leg1231/weird-looking-f1-car/README.md

# weird-looking-f1-car
I built a RC f1 car that uses motors that are to large.

The motors are from a hoverboard that I got that was broken, so as one does they put it in a little car that creates enough torque to do a burnout at 25% throttle. You can use it however you like, I drive it around a parking lot, if you want to build two you could race them. 

Features
- each wheel is individually stearable( revers or positve ackerman)
- 3d printed ( easy to repair)
- FUN
- 3ft long
- personalizable
- driftable

- I don’t have a full step file of all parts because it was to large :)

38F4417C-0CD1-4FBF-A528-06B974A8FFAD_1_105_c

DDD26E48-8DF4-418B-BD40-80D3314D60D0_1_105_c

770DDBE2-6F72-454E-91C3-B64E4C116AA4_1_105_c
