leg1231/weird-looking-f1-car/code/Instrustions -code (1).pdf

## Code Instructions

- Install micro python onto 2 raspberry pi pico 2’s
- Once installed, download the lora library file
- Save the lora library code onto both picos as “lora.py”
- Download the receiver code and the transmitter code
- Save the receiver code onto a picos as “main.py”
- Mark which one you have as the receiver
- Save the transmitter code onto the other as “main.py”
- Mark the transmitter code as transmitter
