leg1231/weird-looking-f1-car/wire diagram/receiver_ car.png

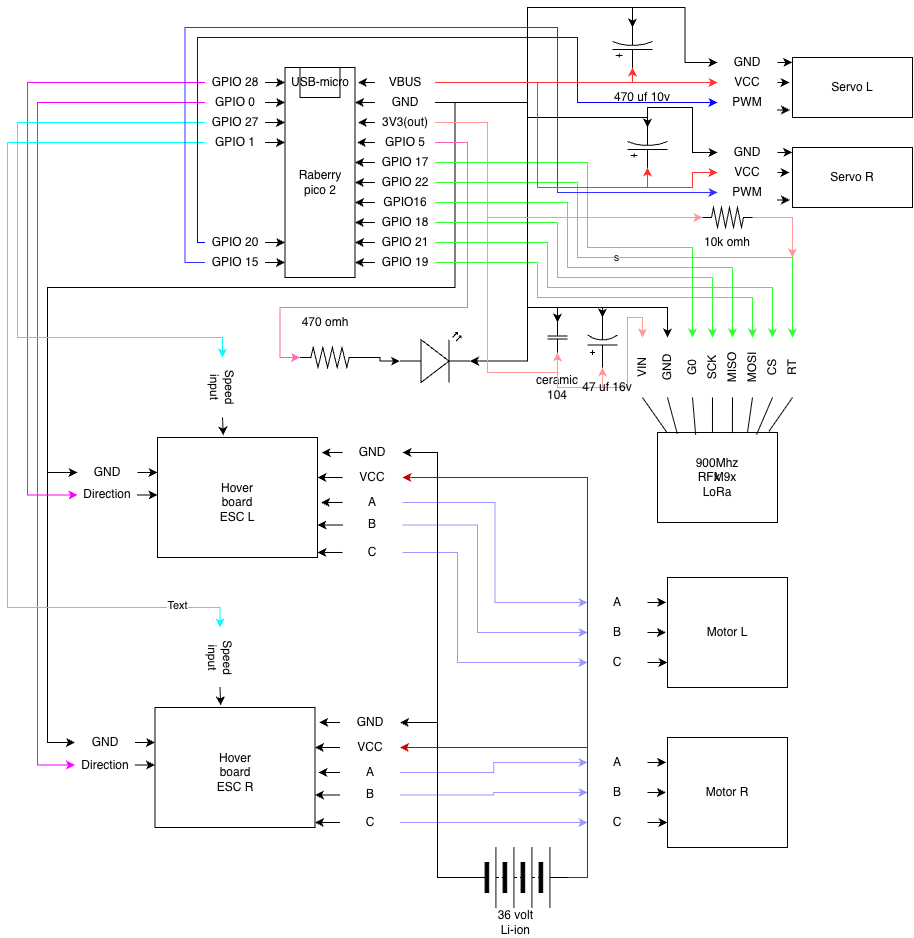
wire diagram/receiver_ car.png
