leg1231/weird-looking-f1-car/wire diagram/transmitter_ remote.png

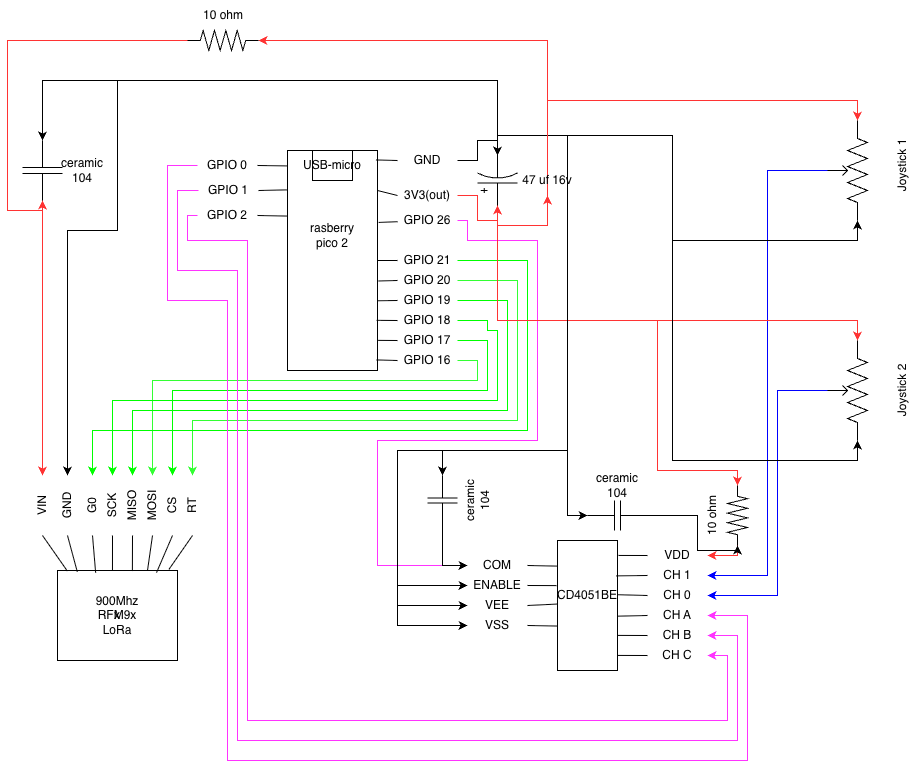
wire diagram/transmitter_ remote.png
