leg1231/weird-looking-f1-car/BOM - Sheet1.csv

ITEM | PRICE | LINK
#10-32TPI 5/8in screw x26 | $6.28 | https://www.homedepot.com/p/Everbilt-10-32-x-5-8-in-Zinc-Plated-Combo-Round-Head-Machine-Screw-8-Pack-828551/317479056
#10-32TPI 1 1/4in screw x8 | $3.14 | https://www.homedepot.com/p/10-32-x-1-1-4-in-Zinc-Plated-Combo-Round-Head-Machine-Screw-5-Pack-830641/317479059
#10-32TPI nuts x34 | $4.71 | https://www.homedepot.com/p/Everbilt-10-32-Zinc-Plated-Machine-Screw-Nut-12-Pieces-826331/317478809
#10 washers x68 | $6.87 | https://www.homedepot.com/p/Everbilt-10-Zinc-Flat-Washer-100-Pack-800442/204276404
8x22x7mm bearings x14 | $19.25 | https://www.amazon.com/gp/product/B0BZT4WDCG/ref=ox_sc_act_title_7?th=1
steering servos x2 | $37.98 | https://www.amazon.com/gp/product/B0CCDN233L/ref=ewc_pr_img_13?smid=A2QTZX14X1D97I&psc=1
motor battery | $41.99 | https://www.amazon.com/gp/product/B0HKS4WVCJ/ref=ewc_pr_img_1?smid=A3L98XJAOS9GRC&psc=1
pico battery | $7.59 | https://www.amazon.com/cart/smart-wagon?newItems=5b2092ab-e2e2-4336-8974-d1ee8a0231cd,1
perfboard | $9.99 | https://www.amazon.com/cart/smart-wagon?newItems=e81c6068-6d89-4af6-82b2-67d0c99dd422,1
electrolytic capacitor | $9.99 | https://www.amazon.com/gp/product/B0F1V24SG9/ref=ewc_pr_img_17?smid=ARPNI681JK4HR&psc=1
ceramic capacitors | $6.99 | https://www.amazon.com/gp/product/B07X5XTDPB/ref=ewc_pr_img_18?smid=A2RFXKS6GNXFWP&psc=1
LoRa modual x2 | $39.90 | https://www.adafruit.com/product/3072
Pico 2 x2 | $12.50 | https://www.adafruit.com/product/6006
CD4051 | $6.99 | https://www.amazon.com/cart/smart-wagon?newItems=8668cab5-509c-4a83-8b9f-52ce7bab90b8,1
Joystick | $13.99 | https://www.amazon.com/gp/product/B09JZ8ZV4L/ref=ewc_pr_img_20?smid=ADJSE8KRWYR5&psc=1
motors esc x2 | $29.18 | https://www.amazon.com/gp/product/B0DBSNV86J/ref=ewc_pr_img_5?smid=A1ASY00QOMN6RD&psc=1
hoverboard motors | $10.00 | find a broken hoverboard and use the motors- i found one at goodwill
PLA 5kg | $67.45 | https://us.store.bambulab.com/products/pla-basic-filament
TPU 85A 1kg | $44.99 | https://us.store.bambulab.com/products/tpu-85a-tpu-90a?id=573761693833371666
