leg1231/weird-looking-f1-car/CAD files/base plate/Motor holder RIGHT.step

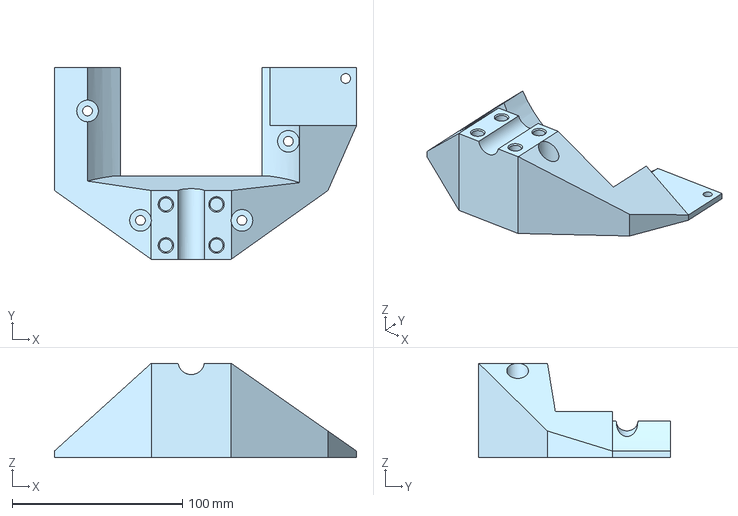
[picture p3: CAD file, 2026-10-25]
CAD files/base plate/Motor holder RIGHT.step
177.2 x 112.4 x 55.3 mm
