leg1231/weird-looking-f1-car/CAD files/body/chassi dowls - Part 1.step

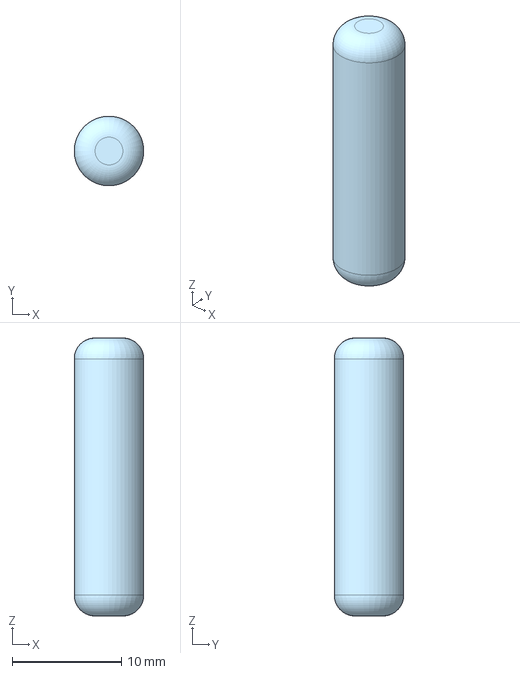
[picture p4: CAD file, 2026-10-25]
CAD files/body/chassi dowls - Part 1.step
6.34 x 6.35 x 25.4 mm
