leg1231/weird-looking-f1-car/CAD files/drive train/gear mount LEFT.step

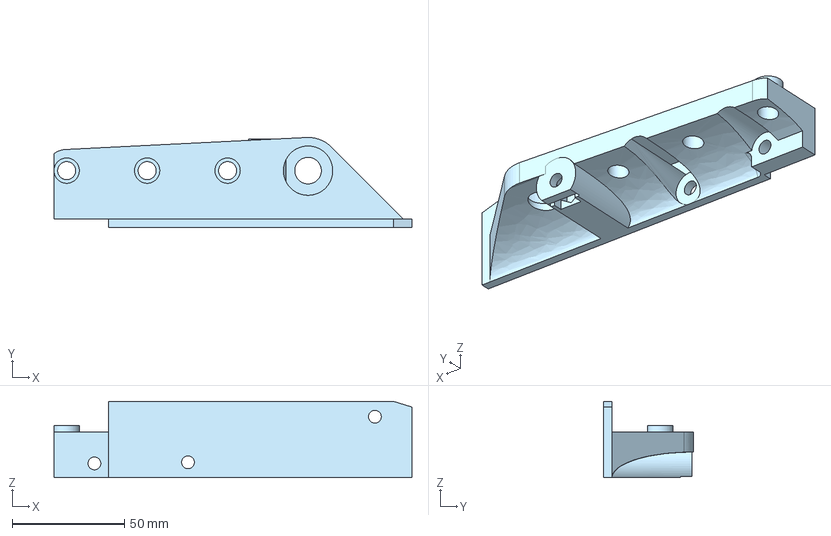
[picture p5: CAD file, 2026-10-25]
CAD files/drive train/gear mount LEFT.step
159.7 x 40.2 x 34.0 mm
