leg1231/weird-looking-f1-car/CAD files/steering LEFT/front wing cap (2).step

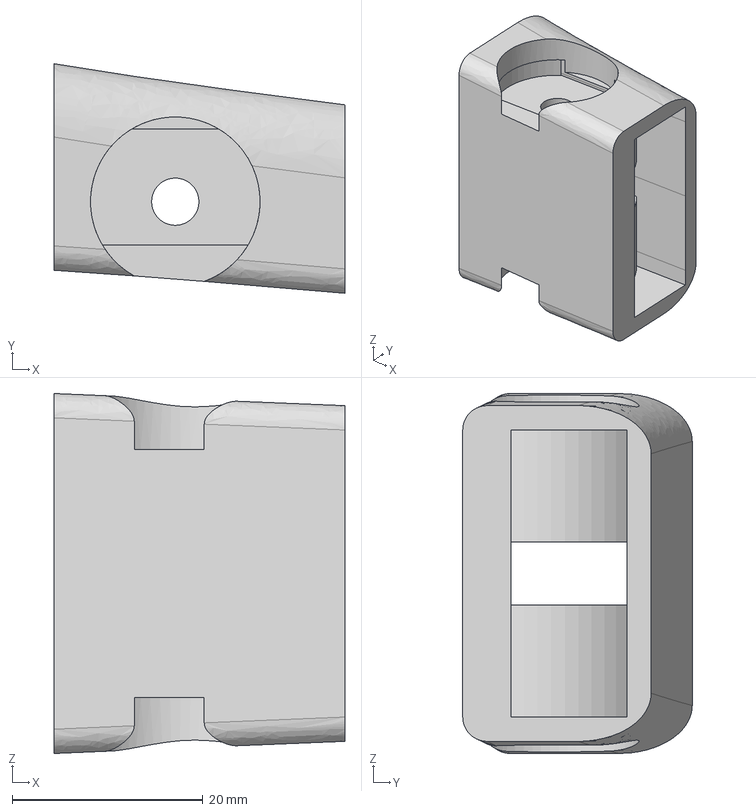
[picture p6: CAD file, 2026-10-25]
CAD files/steering LEFT/front wing cap (2).step
30.5 x 24.1 x 37.8 mm
