leg1231/weird-looking-f1-car/CAD files/steering nuckle RIGHT.step

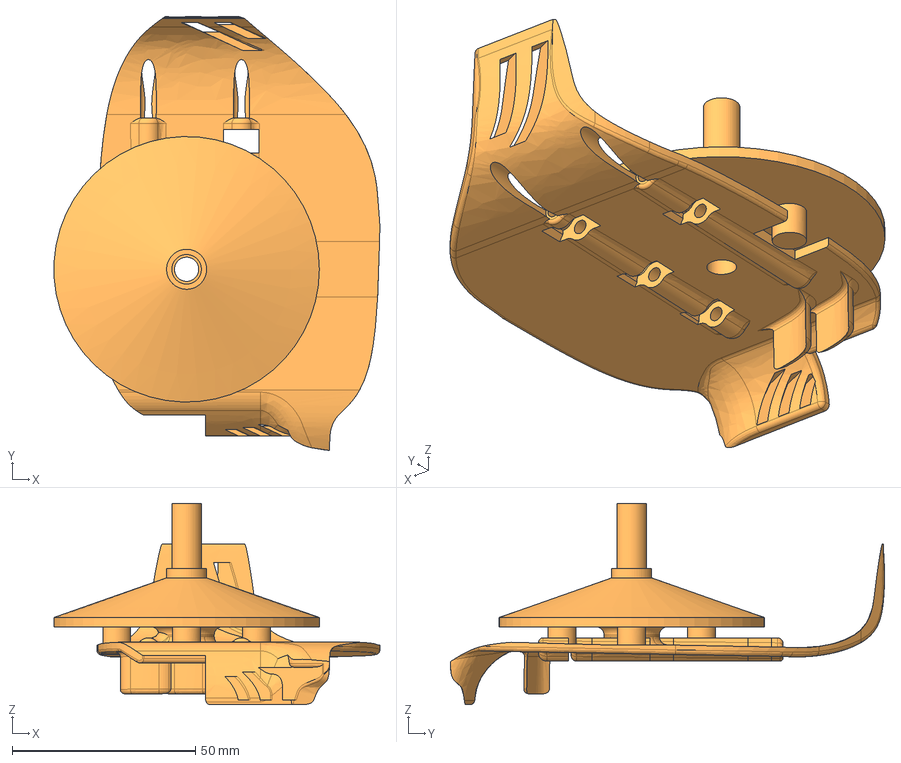
[picture p7: CAD file, 2026-10-25]
CAD files/steering nuckle RIGHT.step
88.8 x 118.3 x 54.9 mm
