leg1231/weird-looking-f1-car/CAD files/steering RIGHT/Wheel rim FRONT.step

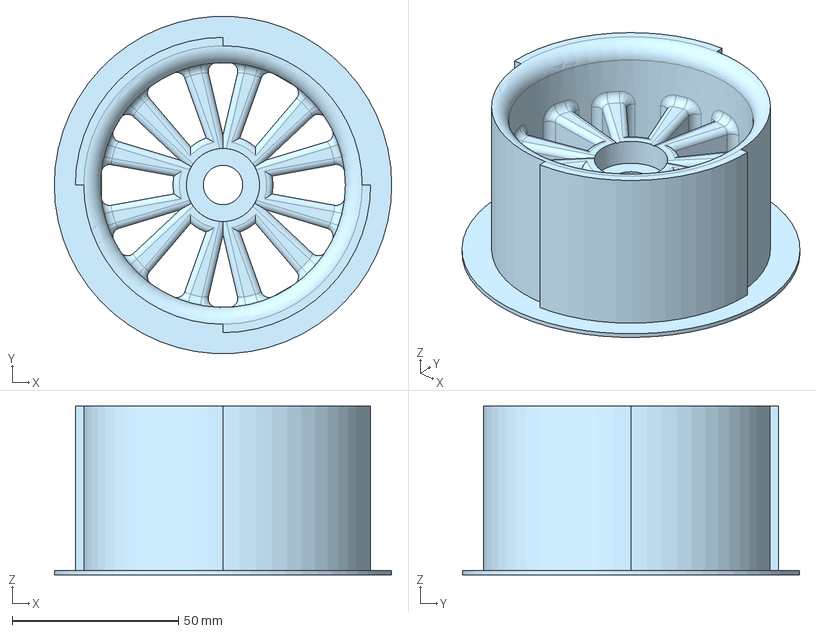
[picture p8: CAD file, 2026-10-25]
CAD files/steering RIGHT/Wheel rim FRONT.step
101.6 x 101.5 x 50.8 mm
