leg1231/weird-looking-f1-car/CAD files/base plate/base plate MIDDLE.step

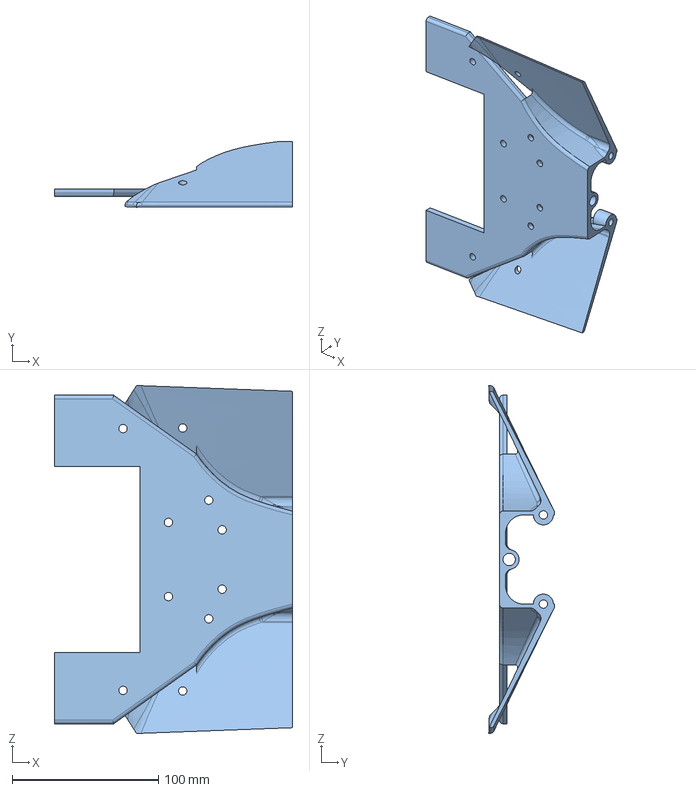
[picture p9: CAD file, 2026-10-25]
CAD files/base plate/base plate MIDDLE.step
163.1 x 45.1 x 238.2 mm
