leg1231/weird-looking-f1-car/CAD files/body/USB battery holder.step

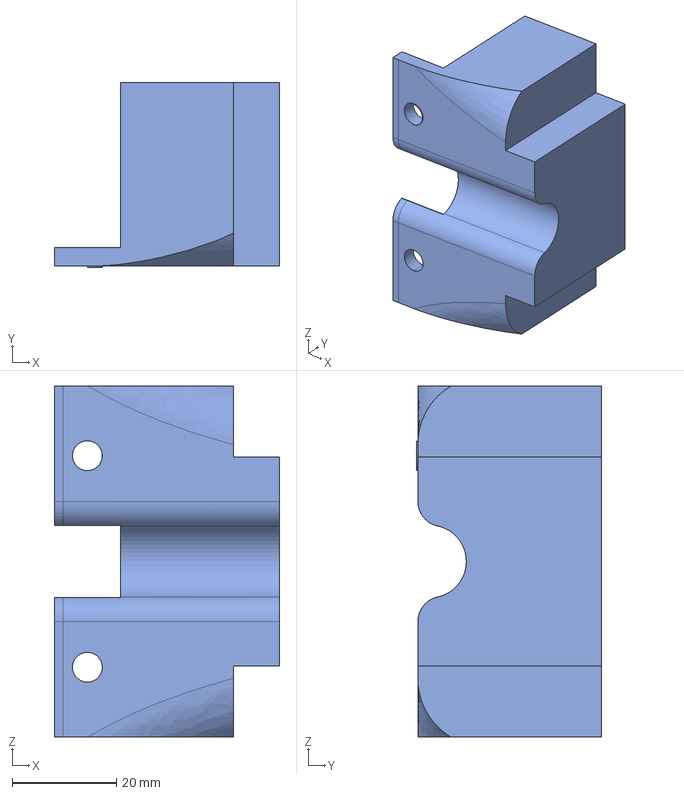
[picture p10: CAD file, 2026-10-25]
CAD files/body/USB battery holder.step
43.3 x 35.6 x 67.4 mm
