leg1231/weird-looking-f1-car/CAD files/drive train/motor gear 64 tooth x2.step

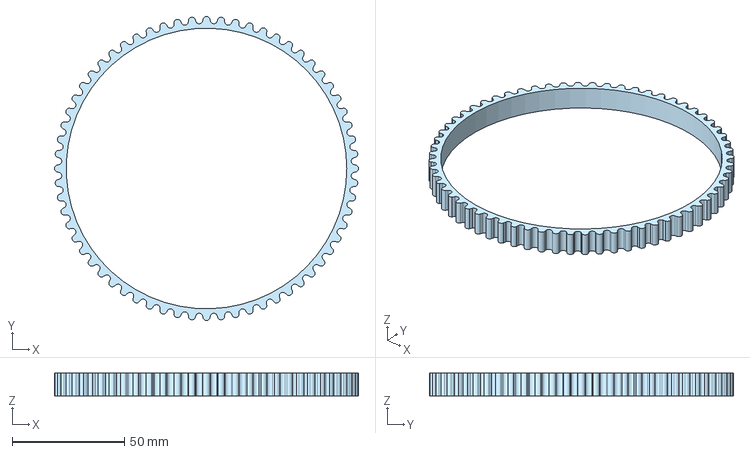
[picture p11: CAD file, 2026-10-25]
CAD files/drive train/motor gear 64 tooth x2.step
135.7 x 135.7 x 10.2 mm
