leg1231/weird-looking-f1-car/CAD files/steering RIGHT/Tire support FRONT.step

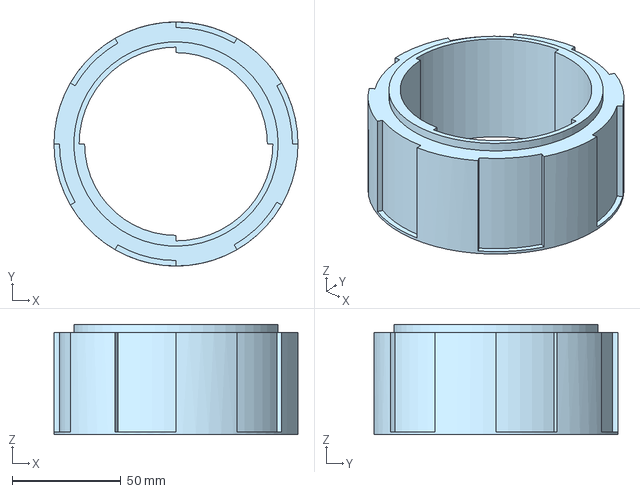
[picture p12: CAD file, 2026-10-25]
CAD files/steering RIGHT/Tire support FRONT.step
112.3 x 112.3 x 50.8 mm
