leg1231/weird-looking-f1-car/CAD files/base plate/base plate FRONT.step

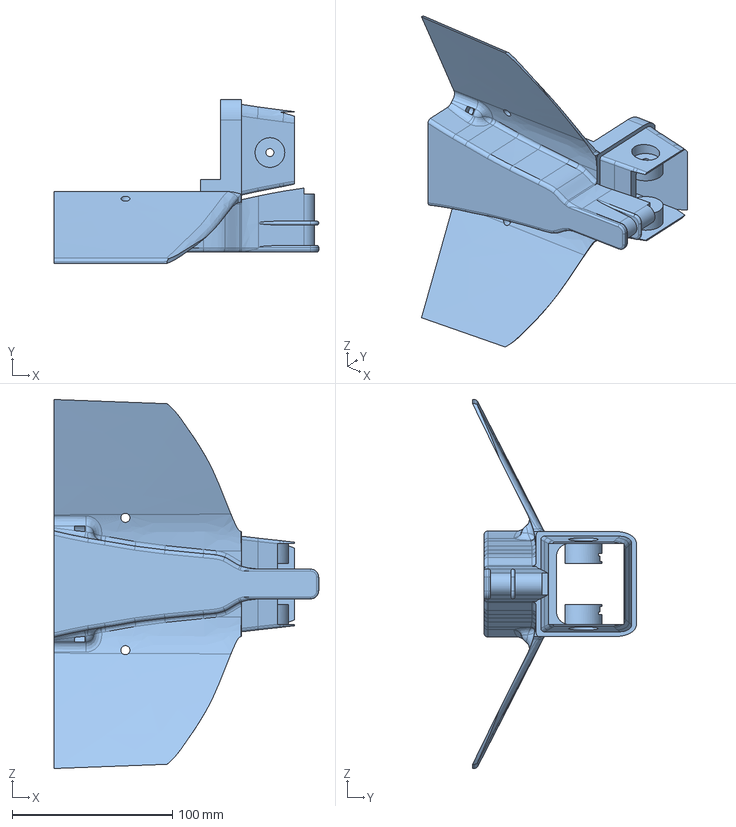
[picture p13: CAD file, 2026-10-25]
CAD files/base plate/base plate FRONT.step
165.1 x 102.2 x 230.3 mm
