leg1231/weird-looking-f1-car/CAD files/body/air intake- esc holder LEFT.step

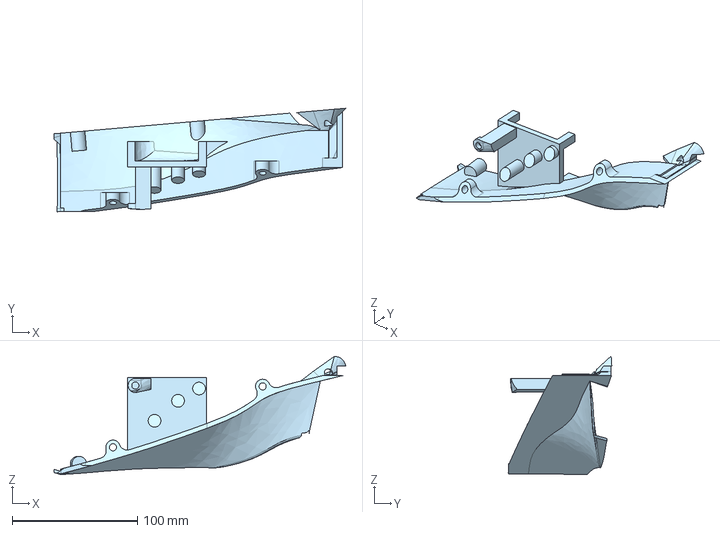
[picture p14: CAD file, 2026-10-25]
CAD files/body/air intake- esc holder LEFT.step
233.5 x 82.8 x 94.5 mm
