leg1231/weird-looking-f1-car/CAD files/drive train/train gear 16 tooth x6.step

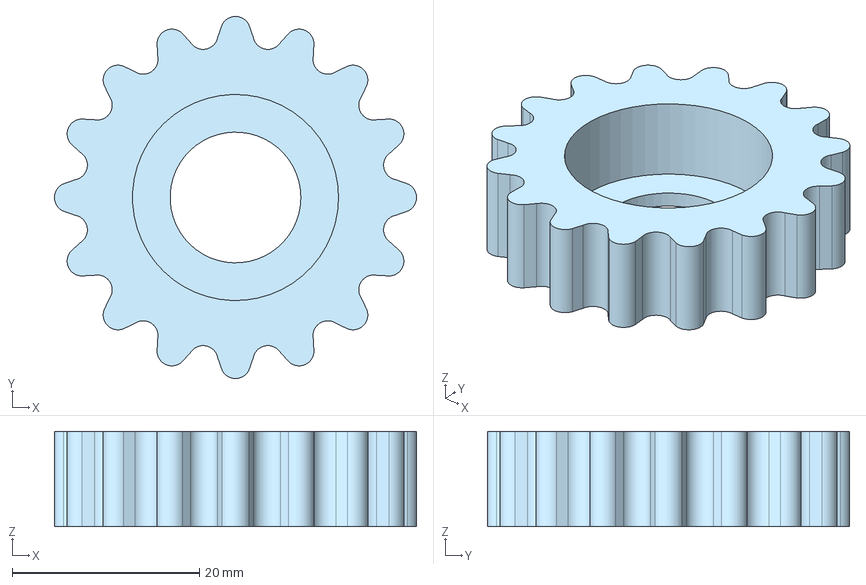
[picture p15: CAD file, 2026-10-25]
CAD files/drive train/train gear 16 tooth x6.step
38.7 x 38.7 x 10.2 mm
