leg1231/weird-looking-f1-car/CAD files/steering RIGHT/Tire FRONT.step

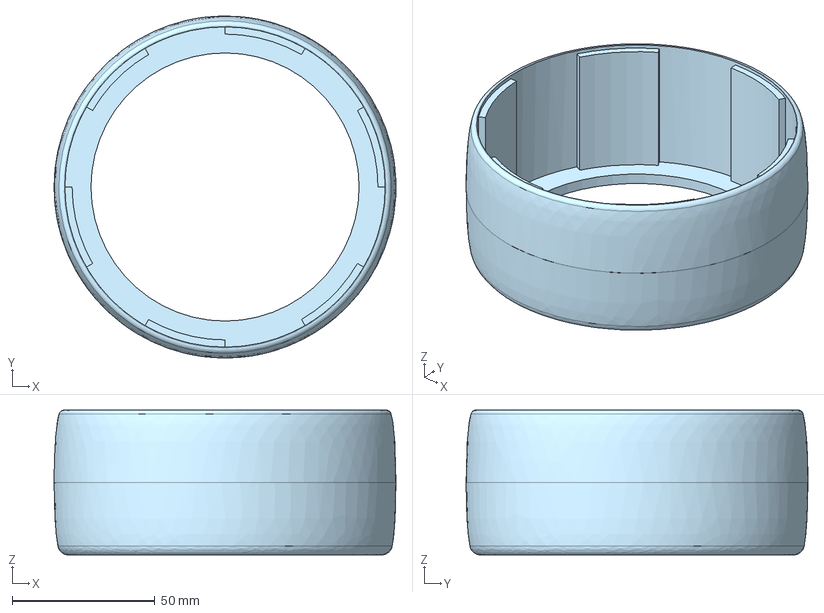
[picture p16: CAD file, 2026-10-25]
CAD files/steering RIGHT/Tire FRONT.step
119.9 x 119.9 x 50.8 mm
