leg1231/weird-looking-f1-car/CAD files/steering servo case+front struts LEFT.step

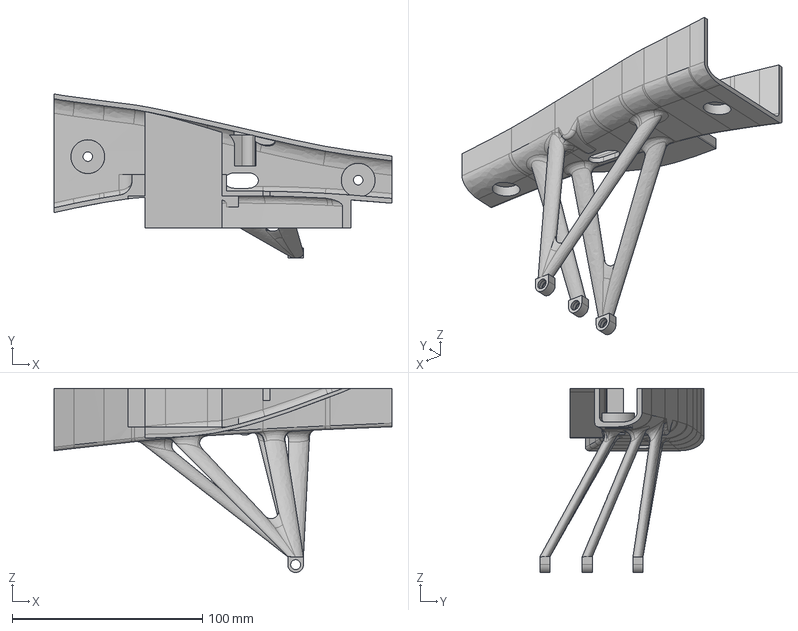
[picture p17: CAD file, 2026-10-25]
CAD files/steering servo case+front struts LEFT.step
177.7 x 86.4 x 96.8 mm
