leg1231/weird-looking-f1-car/CAD files/body/air intake- esc holder RIGHT.step

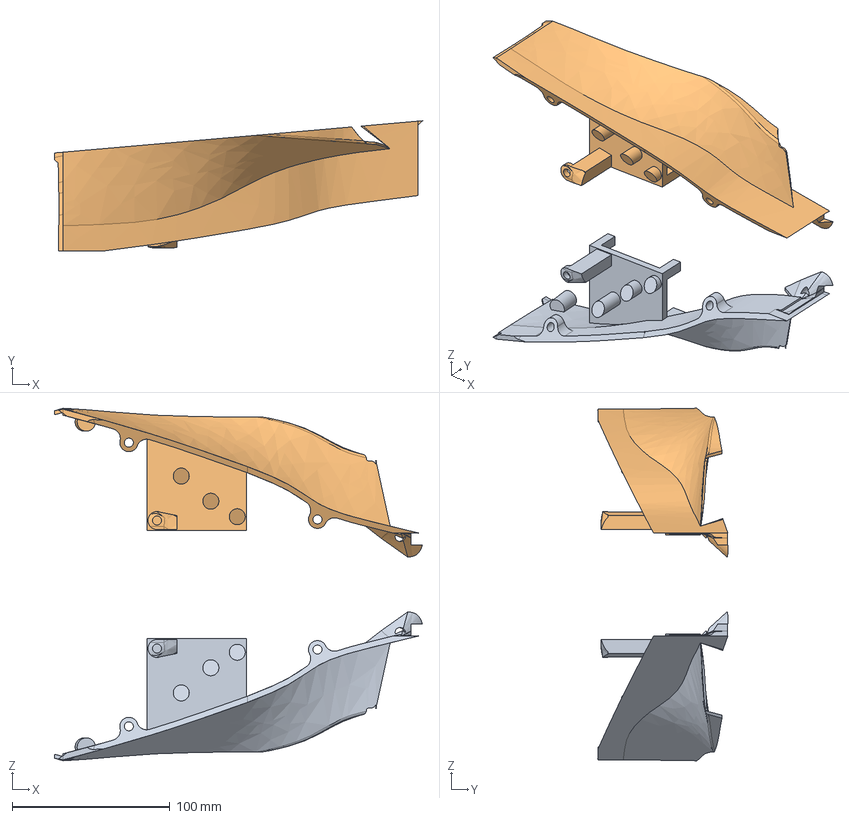
[picture p18: CAD file, 2026-10-25]
CAD files/body/air intake- esc holder RIGHT.step
233.5 x 82.8 x 223.7 mm
