leg1231/weird-looking-f1-car/CAD files/drive train/rear strut RIGHT.step

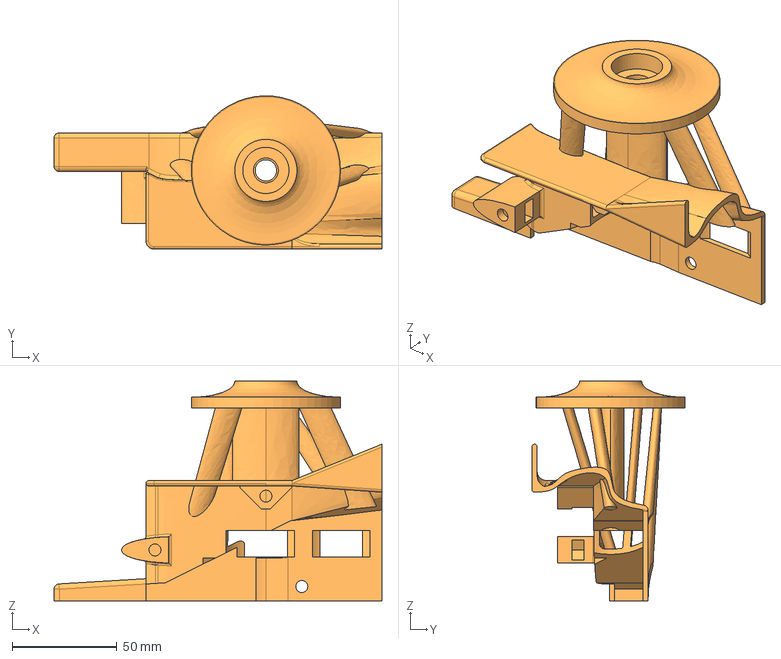
[picture p19: CAD file, 2026-10-25]
CAD files/drive train/rear strut RIGHT.step
156.4 x 73.1 x 104.7 mm
