leg1231/weird-looking-f1-car/CAD files/steering RIGHT/Steering rod.step

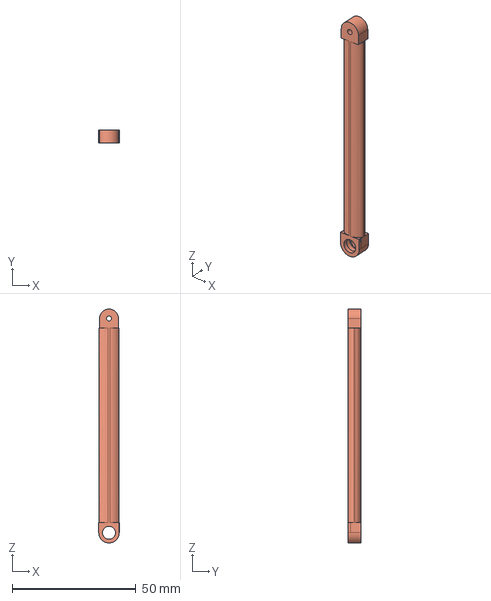
[picture p20: CAD file, 2026-10-25]
CAD files/steering RIGHT/Steering rod.step
8.28 x 5.33 x 94.5 mm
