leg1231/weird-looking-f1-car/CAD files/base plate/base plate BACK.step

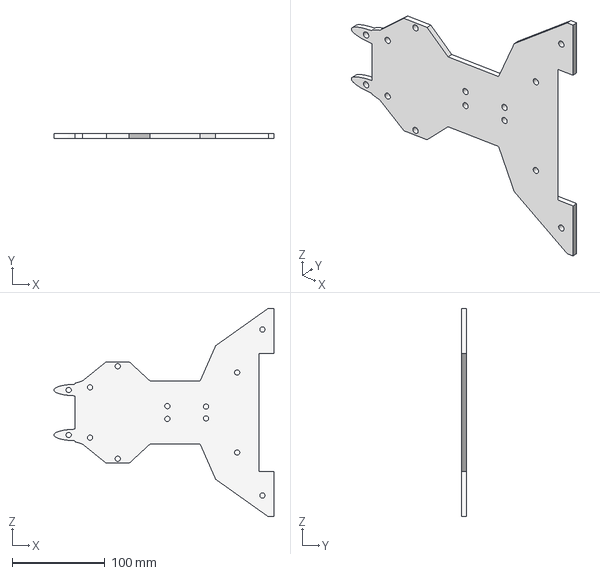
[picture p21: CAD file, 2026-10-25]
CAD files/base plate/base plate BACK.step
237.5 x 5.08 x 224.9 mm
