leg1231/weird-looking-f1-car/CAD files/body/air output.step

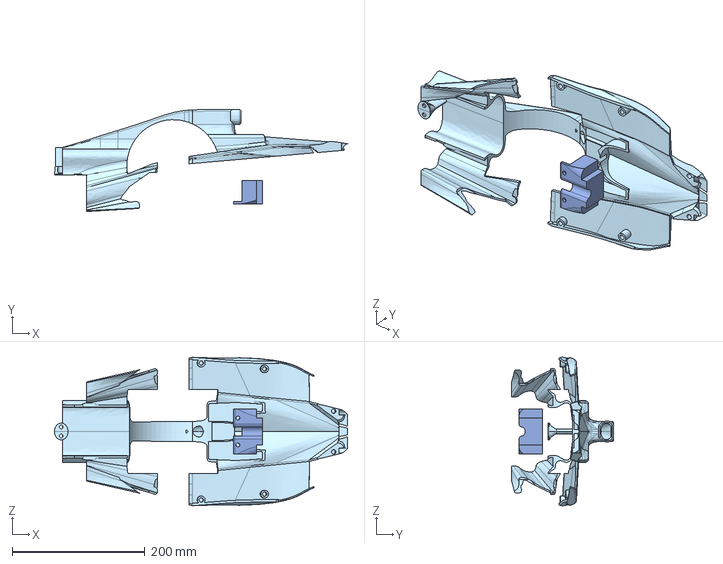
[picture p22: CAD file, 2026-10-25]
CAD files/body/air output.step
441.6 x 154.0 x 223.9 mm
