leg1231/weird-looking-f1-car/CAD files/drive train/Axil jig.step

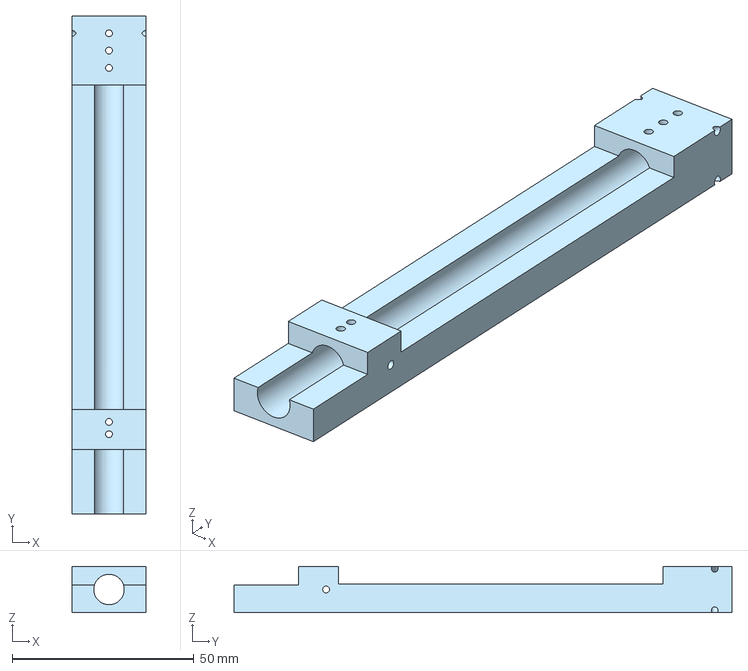
[picture p23: CAD file, 2026-10-25]
CAD files/drive train/Axil jig.step
20.3 x 137.2 x 12.7 mm
