leg1231/weird-looking-f1-car/CAD files/body/cockpit- air intake.step

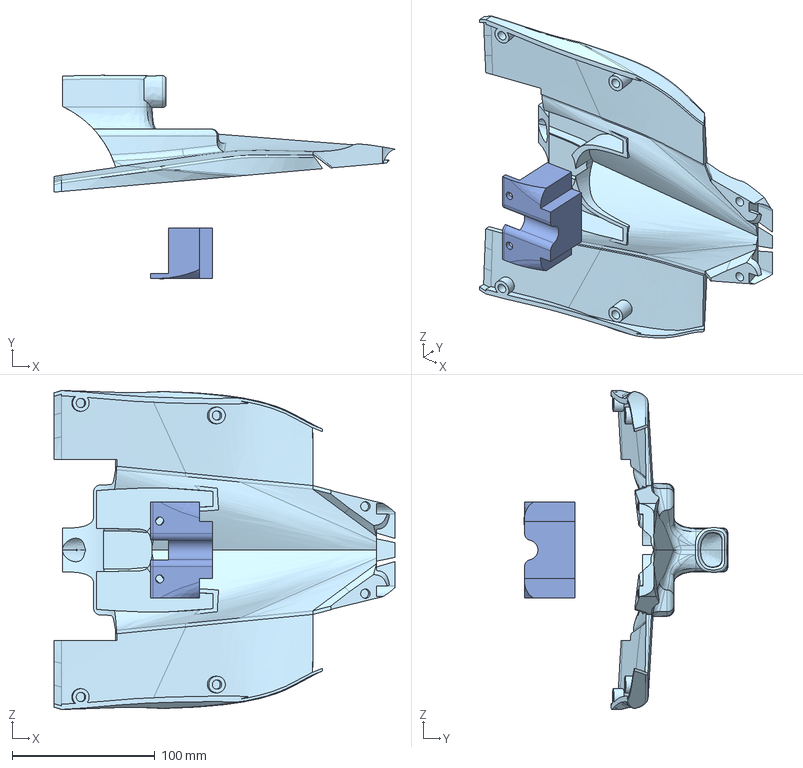
[picture p24: CAD file, 2026-10-25]
CAD files/body/cockpit- air intake.step
239.3 x 142.8 x 223.9 mm
