leg1231/weird-looking-f1-car/CAD files/drive train/gear mount RIGHT.step

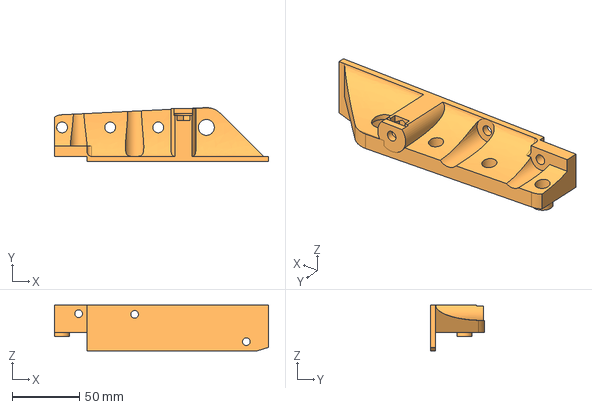
[picture p25: CAD file, 2026-10-25]
CAD files/drive train/gear mount RIGHT.step
159.7 x 40.2 x 34.0 mm
