leg1231/weird-looking-f1-car/CAD files/front wing cap.step

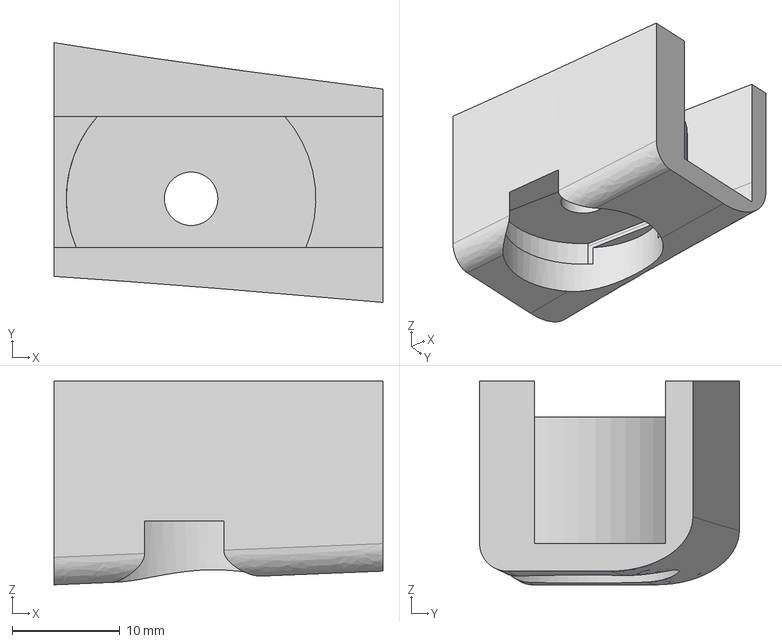
[picture p26: CAD file, 2026-10-25]
CAD files/front wing cap.step
30.5 x 24.1 x 18.9 mm
