leg1231/weird-looking-f1-car/CAD files/drive train/Wheel rim BACK x2.step

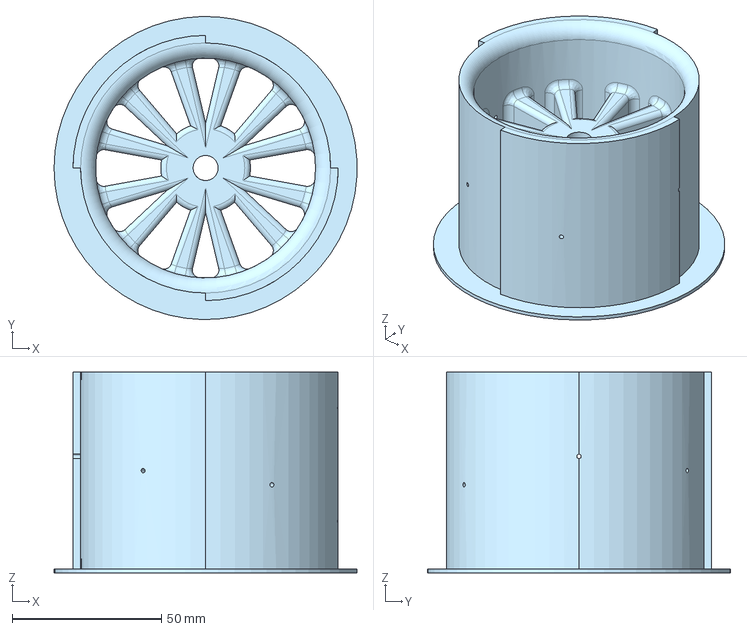
[picture p27: CAD file, 2026-10-25]
CAD files/drive train/Wheel rim BACK x2.step
101.5 x 101.6 x 67.3 mm
