leg1231/weird-looking-f1-car/CAD files/drive train/tire support BACK x2.step

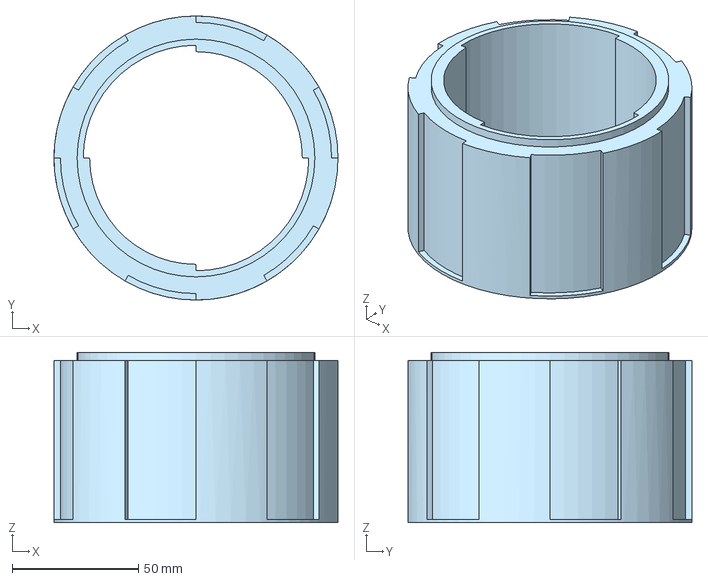
[picture p28: CAD file, 2026-10-25]
CAD files/drive train/tire support BACK x2.step
112.3 x 112.3 x 67.3 mm
