leg1231/weird-looking-f1-car/CAD files/drive train/axil gear 16 tooth x2.step

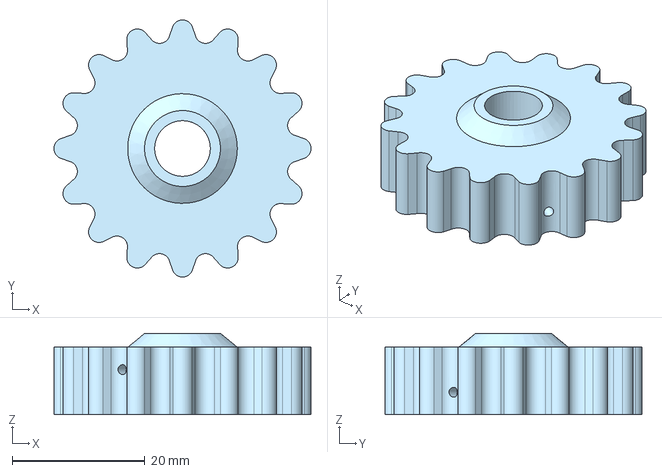
[picture p29: CAD file, 2026-10-25]
CAD files/drive train/axil gear 16 tooth x2.step
38.7 x 38.7 x 12.2 mm
