leg1231/weird-looking-f1-car/CAD files/drive train/tire REAR x2.step

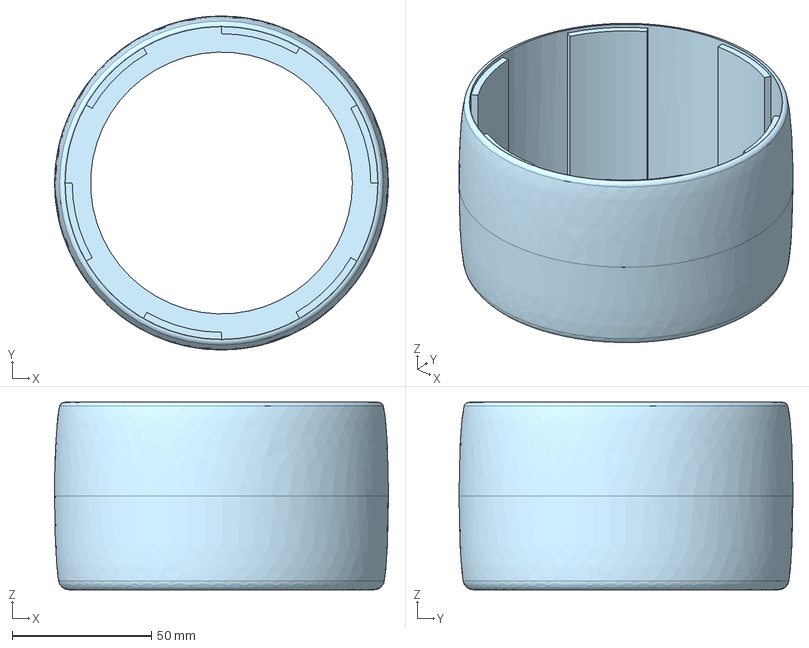
[picture p30: CAD file, 2026-10-25]
CAD files/drive train/tire REAR x2.step
119.9 x 119.9 x 67.3 mm
