leg1231/weird-looking-f1-car/(list of files, cad)

Other CAD files:
CAD files/steering nuckle LEFT.step
CAD files/base plate/Motor holder LEFT.step
CAD files/steering servo case+ front struts RIGHT.step
CAD files/front wing - Part 3.step
CAD files/drive train/rear strut LEFT.step
CAD files/body/air intake- esc holder slanted washer FRONT x2.step
CAD files/body/air intake- esc holder slanted washer REAR x2.step
