leg1231/weird-looking-f1-car/instructions/Instrustions -code.pdf

# Code Instructions

- Have you raspberry picos
