leg1231/weird-looking-f1-car/wire diagram/Instruction - wiring.pdf

## Wiring Instructions

## Transmitter

- The wiring for the transmitter is very simple as it does

not have a form factor it has to fit into.

- I have mine on a breadboard, but may make an actual

remote at some point.

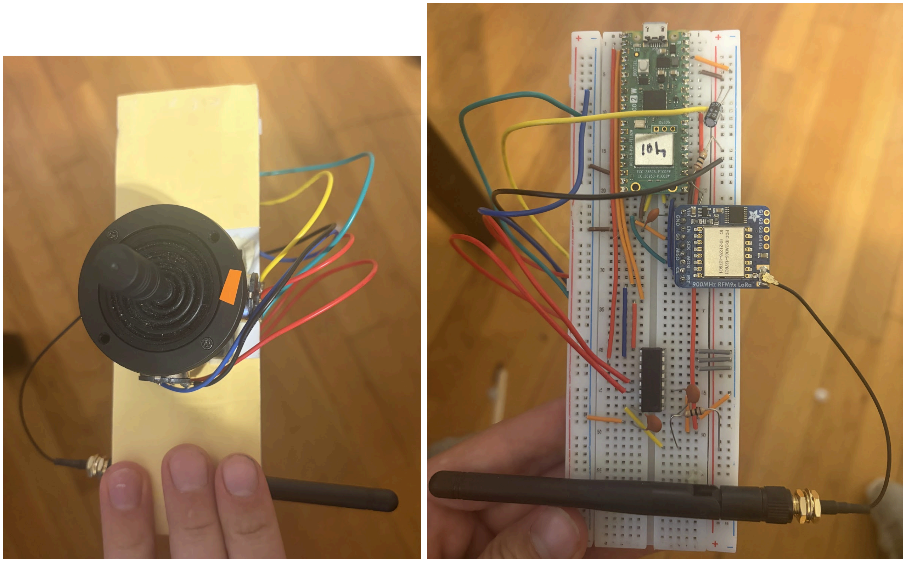
[picture p31: figure]

## Receiver

- I have it wired on a 18x24 perfboard to fit into the car
- You can wire it how you like as long as it follows the

diagram it should work.

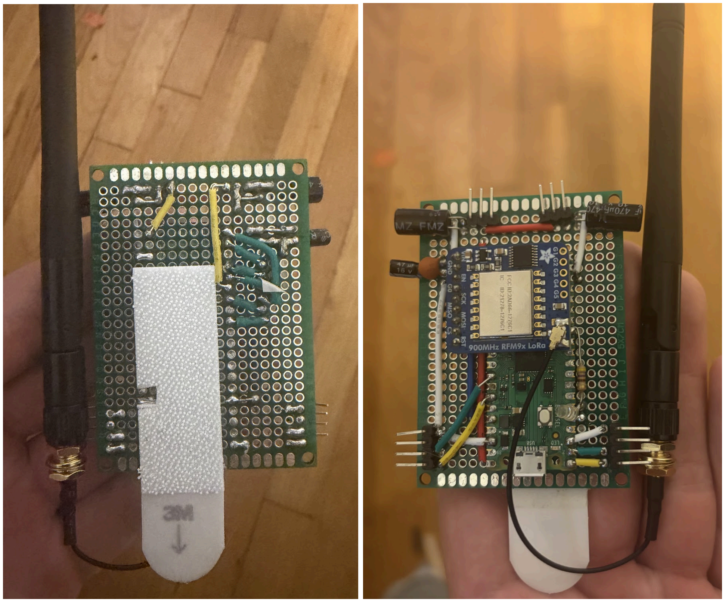
[picture p32: figure]
