leg1231/weird-looking-f1-car/(commit log)

2026-06-06 Create CAD
2026-06-06 Create PCB-Wiring
2026-10-25 Clear contents of BOM.csv
    Remove all content from BOM.csv.
2026-10-25 Create Print settings
2026-10-30 Add YouTube link to base plate instructions
2026-10-30 Add steering instructions link
2026-10-30 Add video tutorial link to steering left instructions
    Added a link to a video tutorial for steering left instructions.
2026-10-30 Add video tutorial link to steering instructions
    Added a link to a video tutorial for steering instructions.
2026-10-30 Add wiring instructions video link
2026-10-30 Fix wording in README about car's torque
    Corrected the wording to clarify that the car can do a burnout at 25% throttle.
